alvarohqr/Sunny/ThousandSunny/CON_MSP430F5529.jpg

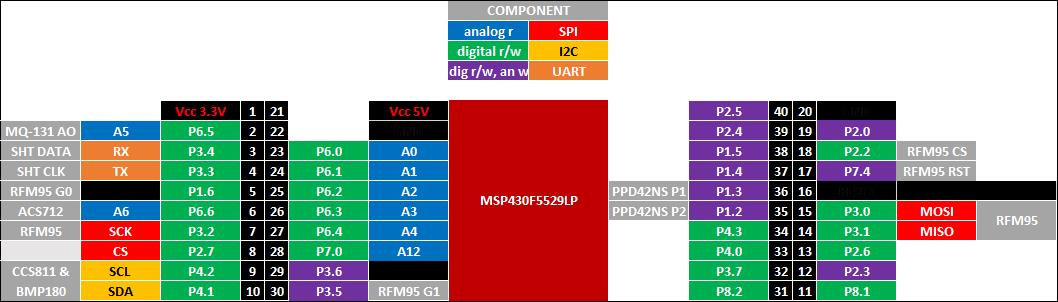
ThousandSunny/CON_MSP430F5529.jpg
