alvarohqr/Sunny/README.md

# A LoRaWAN Air Quality and Meteorological monitoring system based on a MSP430FR5529LP Texas Instruments launchpad.
