alvarohqr/Sunny/PCB/README.md

Thousand Sunny Printed Circuit Board Files.
Software: EaglePCB for designd and EasyEDA for costumization.

IMPORTANT NOTE: the Protection Circuit uses a IRF9Z34 transistor while the Power Saving Circuit a IRLZ44N.
