alvarohqr/Sunny/Energia Libraries/readme.md

Source files for each sensor and the LoRa transceiver.
