alvarohqr/Sunny/ThousandSunny/sensor_node.md

Sensor/End Node components summary:

|Component| Description|
| --- | --- |
|MSP430F5529|Low-power microcontroller.|
|SX1276| 868MHz - 915 MHz LoRa transceiver.|
|SHT10| Temperature & relative humidity sensor.|
|BMP180| Temperature, relative humidity,<br /> and pressure sensor.|
|CCS811| Carbon dioxide and Total Volatile<br /> Organic Compounds (TVOCs) sensor.|
|MQ-131| Ozone sensor.|
|PPD42NS|$PM_{2.5}$ & $PM_{10}$ sensor.|
|ACS712| Current sensor combined with a<br /> solar cell to measure sollar irradiation.|
