alvarohqr/Sunny/PCB/ThousandSunny.png

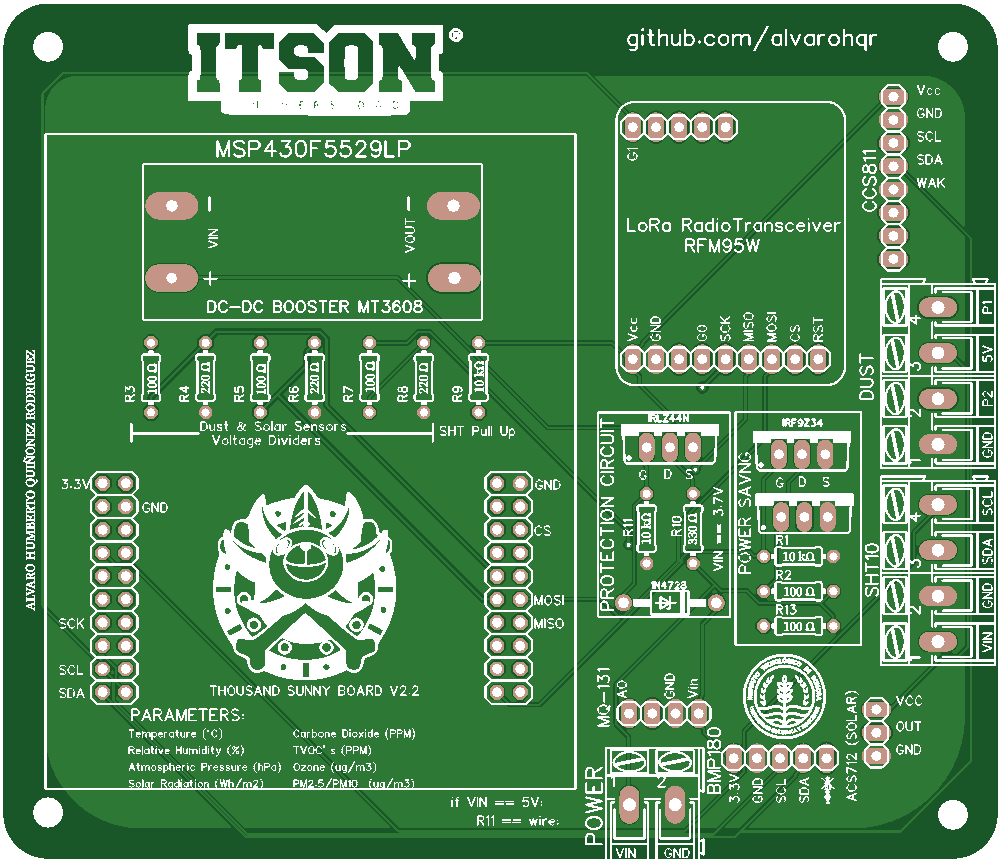
PCB/ThousandSunny.png
