alvarohqr/Sunny/PCB/ThousandSunny.pdf

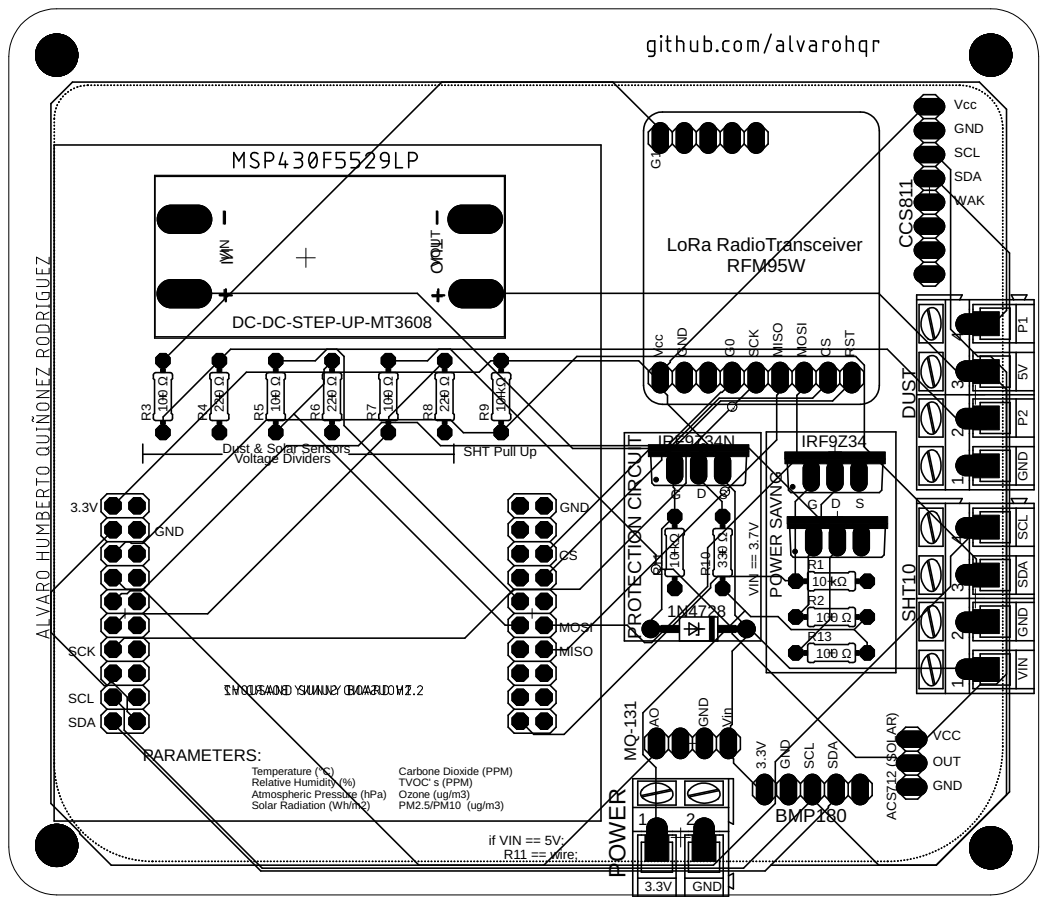
[picture p6: page 1]

GND SDA SCL P2 P1 GND

Vcc GND G0 SCK MISO MOSI CSRST
