alvarohqr/Sunny/(list of files, drawings)

Other design files:
Energia Libraries/Energia-MQ131/extras/MQ131_Arduino_Uno_circuit.fzz
