alvarohqr/Sunny/PCB/ThousandSunny.brd

## EAGLE design PCB/ThousandSunny.brd (2022-12-30)

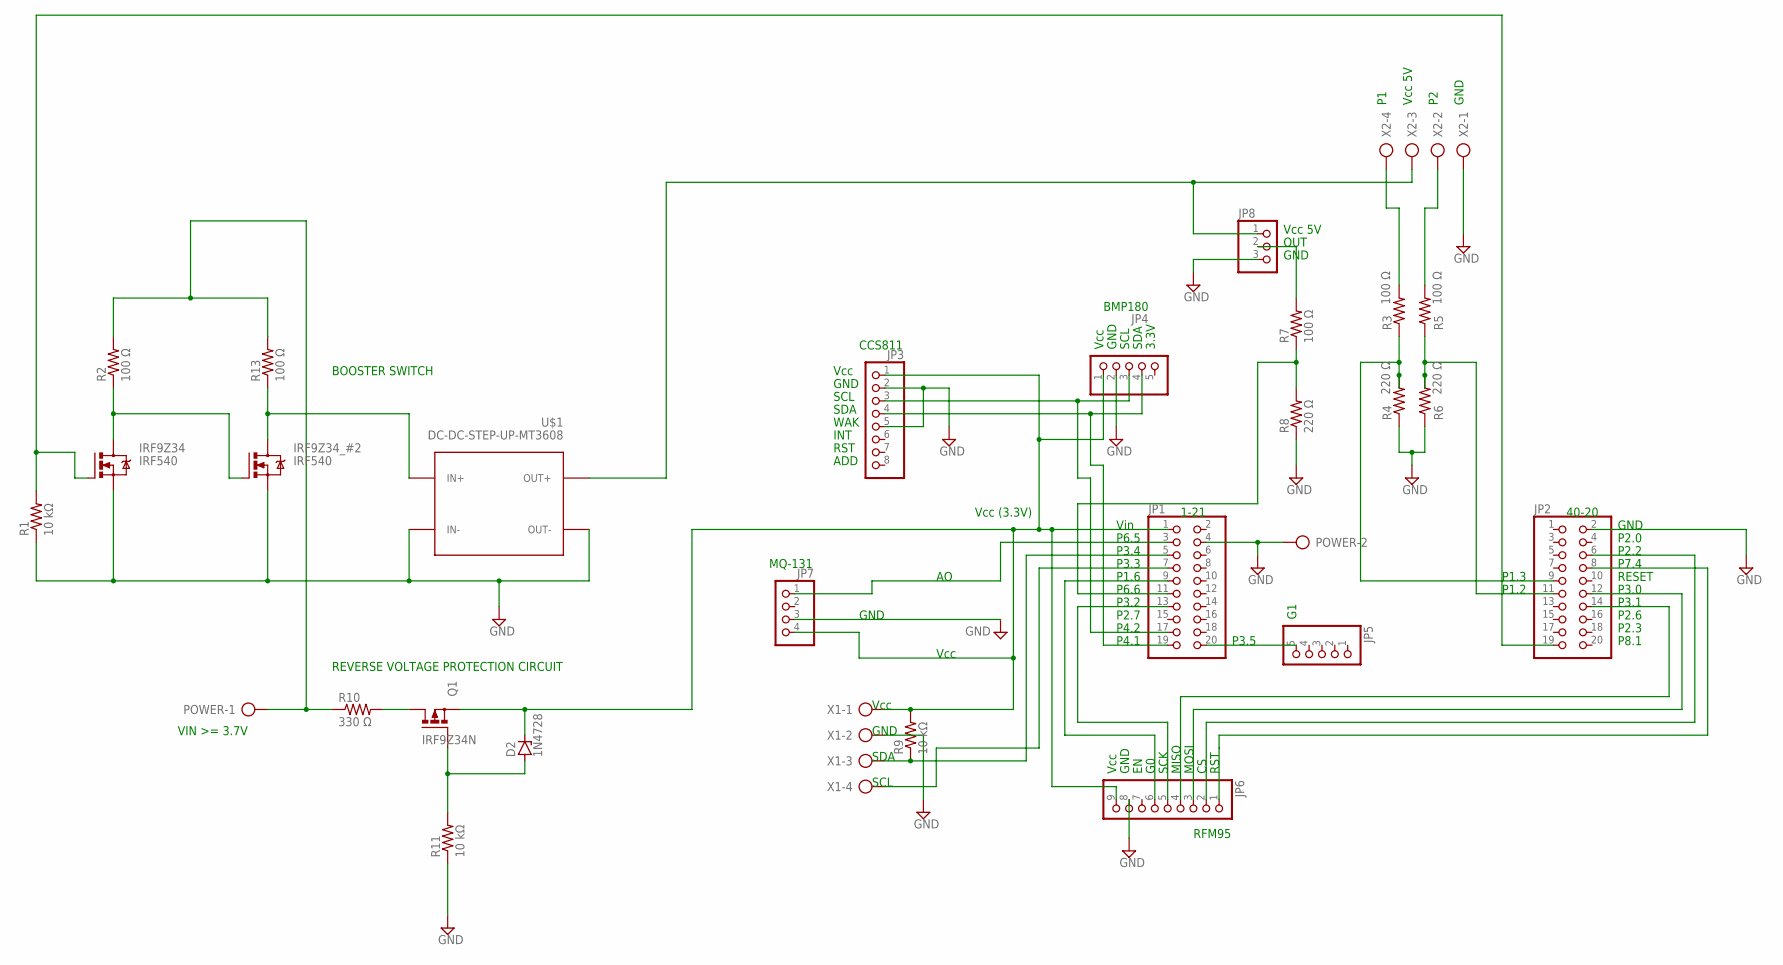
[picture p7: schematic ThousandSunny.sch]

Parts:
D2: 1N4728; DO41Z10
IRF9Z34, IRF9Z34_#2: IRF540; TO220BV
JP1, JP2: PINHD-2X10; 2X10
JP3: PINHD-1X8; 1X08
JP4, JP5: PINHD-1X5; 1X05
JP6: PINHD-1X9; 1X09
JP7: PINHD-1X4; 1X04
JP8: PINHD-1X3; 1X03
POWER: AK300/2
Q1: IRF9Z34N; TO220BV
R1, R9, R11: 10 kΩ; 0204/7
R2, R3, R5, R7, R13: 100 Ω; 0204/7
R4, R6, R8: 220 Ω; 0204/7
R10: 330 Ω; 0204/7
U$1: DC-DC-STEP-UP-MT3608
X1, X2: AK300/4

Connections:
ANODE: D2.A, Q1.G, R11.2
BATTERY: POWER.1, R2.2, R10.1, R13.2
D1->G2: IRF9Z34.D, IRF9Z34_#2.G, R2.1
D2->VIN: IRF9Z34_#2.D, R13.1, U$1.IN+
DRAIN_Q1: Q1.D, R10.2
DUST_P1: JP2.9, R3.1, R4.2
DUST_P2: JP2.11, R5.1, R6.2
G1: JP1.20, JP5.5
GND: IRF9Z34.S, IRF9Z34_#2.S, JP1.4, JP2.2, JP3.2, JP3.5, JP4.2, JP6.8, JP7.3, JP8.3, POWER.2, R1.1, R4.1, R6.1, R8.1, R11.1, U$1.IN-, U$1.OUT-, X1.2, X2.1
MISO: JP2.14, JP6.4
MOSI: JP2.12, JP6.3
O3: JP1.3, JP7.1
P8.2: IRF9Z34.G, JP2.19, R1.2
RAW_P1: R3.2, X2.4
RAW_P2: R5.2, X2.2
RAW_SOLAR: JP8.2, R7.2
RFM95W_CS: JP2.6, JP6.2
RFM95W_G0: JP1.9, JP6.6
RFM95_RST: JP2.8, JP6.1
SCK: JP1.13, JP6.5
SCL: JP1.17, JP3.3, JP4.3
SDA: JP1.19, JP3.4, JP4.4
SHT_CLOCK: JP1.7, X1.4
SHT_DATA: JP1.5, R9.1, X1.3
SOLAR: JP1.11, R7.1, R8.2
VIN->DUST: JP8.1, U$1.OUT+, X2.3
VZ->3.3V: D2.C, JP1.1, JP3.1, JP4.1, JP6.9, JP7.4, Q1.S, R9.2, X1.1

Notes on the sheet:
Vcc (3.3V)
Vcc
GND
SCK
MISO
MOSI
RST
Vin
P6.5
P3.4
P3.3
P1.6
P6.6
P3.2
P2.7
P4.2
P4.1
SCL
SDA
WAK
INT
ADD
P2.0
P7.4
RESET
P3.0
P3.1
P2.6
P2.3
P8.1
P2.2
P3.5
P1.3
P1.2
3.3V
Vcc 5V
1-21
40-20
CCS811
BMP180
RFM95
MQ-131
REVERSE VOLTAGE PROTECTION CIRCUIT
VIN >= 3.7V
BOOSTER SWITCH
OUT

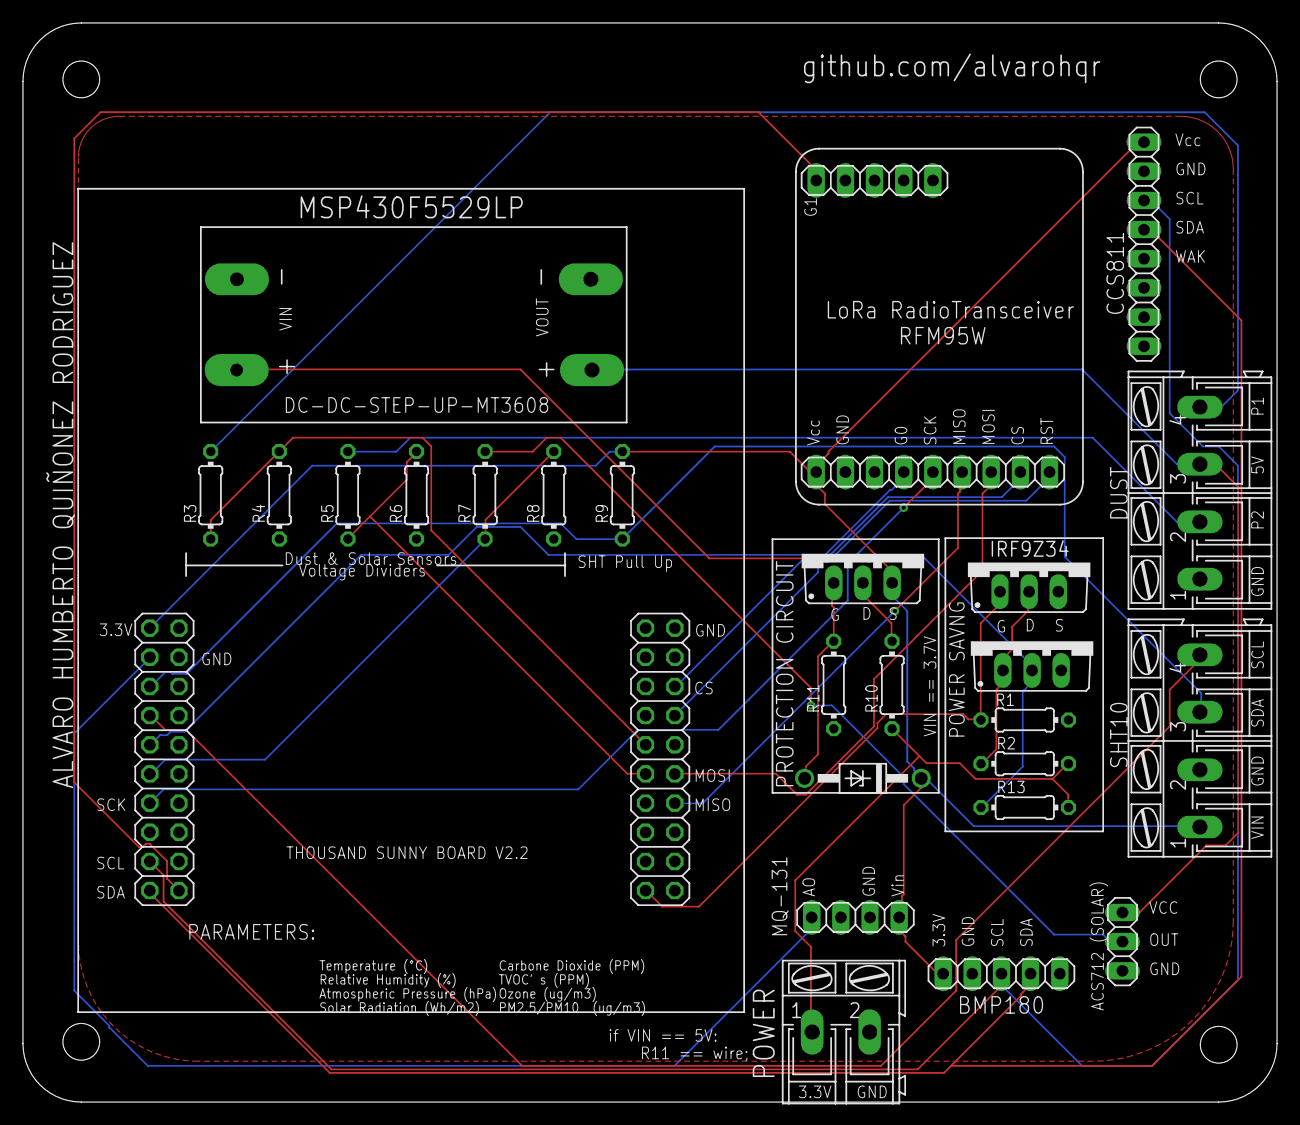
[picture p8: board ThousandSunny.brd from above]

Board: 2 copper layers, 109.2 x 94.0 mm, 28 parts (1 on the bottom side), 27 nets.
