alvarohqr/Sunny/ThousandSunny/Thousand_Sunny.ino

#include <lmic.h>
#include <hal/hal.h>
#include <SPI.h>
#include "TTN_RFM95W.h"

static uint8_t payload[16]; 
static osjob_t sendjob;

// Schedule TX every this many seconds 
// En este caso se define como cero y el parametro 
// para la transmisión se define por el tiempo en reposo.
const unsigned TX_INTERVAL = 0; 

// Pin mapping
const lmic_pinmap lmic_pins = {
  RFM95_CS,   //nss
  LMIC_UNUSED_PIN,    //rxtx
  RFM95_RST,  //rst
  {RFM95_DIO0, RFM95_DIO1, LMIC_UNUSED_PIN},  //{GPIO0, GPIO1, GPIO2}
};

typedef uint16_t u16_t;

//! Variables globales
float temp = 0, hum = 0, temp_i = 0, prsn = 0, con_ugm3 = 0, con2_ugm3 = 0;
u16_t temperature, humidity, pressure, ozone, PM2_5, PM10;
float O3_ppm = -1, O3_ug = -1, R0 = 0;
u16_t eCO2 = -1, TVOC = -1;

void onEvent (ev_t ev) {
  Serial.print(os_getTime());
  Serial.print(": ");
  switch (ev) {
    case EV_SCAN_TIMEOUT:
      Serial.println(F("EV_SCAN_TIMEOUT"));
      break;
    case EV_BEACON_FOUND:
      Serial.println(F("EV_BEACON_FOUND"));
      break;
    case EV_BEACON_MISSED:
      Serial.println(F("EV_BEACON_MISSED"));
      break;
    case EV_BEACON_TRACKED:
      Serial.println(F("EV_BEACON_TRACKED"));
      break;
    case EV_JOINING:
      Serial.println(F("EV_JOINING"));
      break;
    case EV_JOINED:
      Serial.println(F("EV_JOINED"));
      break;
    case EV_RFU1:
      Serial.println(F("EV_RFU1"));
      break;
    case EV_JOIN_FAILED:
      Serial.println(F("EV_JOIN_FAILED"));
      break;
    case EV_REJOIN_FAILED:
      Serial.println(F("EV_REJOIN_FAILED"));
      break;
    case EV_TXCOMPLETE:
      Serial.println(F("EV_TXCOMPLETE (includes waiting for RX windows)"));
      if (LMIC.txrxFlags & TXRX_ACK)
        Serial.println(F("Received ack"));
      if (LMIC.dataLen) {
        Serial.println(F("Received "));
        Serial.println(LMIC.dataLen);
        Serial.println(F(" bytes of payload"));
      }
      // Schedule next transmission
      os_setTimedCallback(&sendjob, os_getTime() + sec2osticks(TX_INTERVAL), do_send);
      sleep(60000);	//! Transmite al menos cada 10 minutos.
      break;
    case EV_LOST_TSYNC:
      Serial.println(F("EV_LOST_TSYNC"));
      break;
    case EV_RESET:
      Serial.println(F("EV_RESET"));
      break;
    case EV_RXCOMPLETE:
      // data received in ping slot
      Serial.println(F("EV_RXCOMPLETE"));
      break;
    case EV_LINK_DEAD:
      Serial.println(F("EV_LINK_DEAD"));
      break;
    case EV_LINK_ALIVE:
      Serial.println(F("EV_LINK_ALIVE"));
      break;
    default:
      Serial.println(F("Unknown event"));
      break;
  }
}

void do_send(osjob_t* j) {
  // Check if there is not a current TX/RX job running
  if (LMIC.opmode & OP_TXRXPEND) {
    Serial.println(F("OP_TXRXPEND, not sending"));
  } else {
    //! Lectura de datos
    read_ppd42ns();
    read_sht();
    read_ccs811();
    read_bmp();
    read_o3();
    
    
    temperature = (u16_t)(temp * 100); // Type casting float a uint16_t
    humidity = (u16_t)(hum * 100);
    pressure = (u16_t)(prsn);
    ozone = (u16_t)(O3_ug * 100);
    PM2_5 = (u16_t)(con_ugm3 *100);
    PM10  = (u16_t)(con2_ugm3 *100);
    
    //! Enpaquetado de datos
    payload[0]  = highByte(temperature); payload[1] = lowByte(temperature);
    payload[2]  = highByte(humidity); payload[3] = lowByte(humidity);
    payload[4]  = highByte(eCO2); payload[5] = lowByte(eCO2);
    payload[6]  = highByte(TVOC); payload[7] = lowByte(TVOC);
    payload[8]  = highByte(pressure); payload[9] = lowByte(pressure);
    payload[10] = highByte(ozone); payload[11] = lowByte(ozone);
    payload[12] = highByte(PM2_5); payload[13] = lowByte(PM2_5);
    payload[14] = highByte(PM10); payload[15] = lowByte(PM10);
    
    // Prepare upstream data transmission at the next possible time.
    LMIC_setTxData2(1, payload, sizeof(payload), 0);
    Serial.println(F("Packet queued"));
  }
  // Next TX is scheduled after TX_COMPLETE event.
}

void setup() {
  Serial.begin(115200);
  Serial.println(F("Starting"));
  setup_ppd42ns();
  init_gpio();
  setup_ccs811();
  delay(1000); //! El sensor CCS811 necesita 1 segundo para estabilizarse.
  setup_bmp();
  setup_o3();
  
  
  // LMIC init
  os_init();
  // Reset the MAC state. Session and pending data transfers will be discarded.
  LMIC_reset();

  // Set static session parameters. Instead of dynamically establishing a session
  // by joining the network, precomputed session parameters are be provided.
#ifdef PROGMEM
  // On AVR, these values are stored in flash and only copied to RAM
  // once. Copy them to a temporary buffer here, LMIC_setSession will
  // copy them into a buffer of its own again.
  uint8_t appskey[sizeof(APPSKEY)];
  uint8_t nwkskey[sizeof(NWKSKEY)];
  memcpy_P(appskey, APPSKEY, sizeof(APPSKEY));
  memcpy_P(nwkskey, NWKSKEY, sizeof(NWKSKEY));
  LMIC_setSession (0x1, DEVADDR, nwkskey, appskey);
#else
  // If not running an AVR with PROGMEM, just use the arrays directly
  LMIC_setSession (0x1, DEVADDR, NWKSKEY, APPSKEY);
#endif

#if defined(CFG_eu868)
  // Set up the channels used by the Things Network, which corresponds
  // to the defaults of most gateways. Without this, only three base
  // channels from the LoRaWAN specification are used, which certainly
  // works, so it is good for debugging, but can overload those
  // frequencies, so be sure to configure the full frequency range of
  // your network here (unless your network autoconfigures them).
  // Setting up channels should happen after LMIC_setSession, as that
  // configures the minimal channel set.
  // NA-US channels 0-71 are configured automatically
  LMIC_setupChannel(0, 868100000, DR_RANGE_MAP(DR_SF12, DR_SF7),  BAND_CENTI);      // g-band
  LMIC_setupChannel(1, 868300000, DR_RANGE_MAP(DR_SF12, DR_SF7B), BAND_CENTI);      // g-band
  LMIC_setupChannel(2, 868500000, DR_RANGE_MAP(DR_SF12, DR_SF7),  BAND_CENTI);      // g-band
  LMIC_setupChannel(3, 867100000, DR_RANGE_MAP(DR_SF12, DR_SF7),  BAND_CENTI);      // g-band
  LMIC_setupChannel(4, 867300000, DR_RANGE_MAP(DR_SF12, DR_SF7),  BAND_CENTI);      // g-band
  LMIC_setupChannel(5, 867500000, DR_RANGE_MAP(DR_SF12, DR_SF7),  BAND_CENTI);      // g-band
  LMIC_setupChannel(6, 867700000, DR_RANGE_MAP(DR_SF12, DR_SF7),  BAND_CENTI);      // g-band
  LMIC_setupChannel(7, 867900000, DR_RANGE_MAP(DR_SF12, DR_SF7),  BAND_CENTI);      // g-band
  LMIC_setupChannel(8, 868800000, DR_RANGE_MAP(DR_FSK,  DR_FSK),  BAND_MILLI);      // g2-band
  // TTN defines an additional channel at 869.525Mhz using SF9 for class B
  // devices' ping slots. LMIC does not have an easy way to define set this
  // frequency and support for class B is spotty and untested, so this
  // frequency is not configured here.
#elif defined(CFG_us915)
  // NA-US channels 0-71 are configured automatically
  // but only one group of 8 should (a subband) should be active
  // TTN recommends the second sub band, 1 in a zero based count.
  // https://github.com/TheThingsNetwork/gateway-conf/blob/master/US-global_conf.json
  LMIC_selectSubBand(1);
#endif

  // Disable link check validation
  LMIC_setLinkCheckMode(0);

  // TTN uses SF9 for its RX2 window.
  LMIC.dn2Dr = DR_SF9;

  // Set data rate and transmit power for uplink (note: txpow seems to be ignored by the library)
  LMIC_setDrTxpow(DR_SF7, 14);

  // Start job
  do_send(&sendjob);
}

void loop() {
  os_runloop_once();
}

void init_gpio() {
  //UCSCTL4 = SELA_1;
  P1OUT = 0x00; P2OUT = 0x00; P3OUT = 0x00; P4OUT = 0x00; P5OUT = 0x00; //P6OUT = 0x00;
  //PJOUT = 0x00;
  P1DIR = 0xFF; P2DIR = 0xFF; P3DIR = 0xFF; P4DIR = 0xFF; P5DIR = 0xFF; //P6DIR = 0xFF;
  //PJDIR = 0xFF;
}
