alvarohqr/Sunny/(commit log)

2022-10-05 Pin Map
2022-10-05 Sensor node components summary
2022-10-05 Sensor node summary
2022-10-05 Interact Adafruit devices
2022-10-05 Components Source Files
    [MQ131_Arduino_Uno_circuit.fzz, Sensitivity_curves.xlsx]
2022-10-05 Sensor Node
2022-10-09 Board logo
2022-10-09 Gerber files
2022-10-09 PCB files
2022-10-18 Power Consumption Data
    [BMP Comp..xlsx, BMP_EnergyTrace_2022_08_02_211659.csv, BMP_NOPT.csv, BMP_OPT.xlsx, EnergyTrace_2022_05_05_171423.csv, EnergyTrace_2022_05_05_171423.xlsx, LoRa.xlsx, MQ131_EnergyTrace_2022_05_06_183339.csv]
2022-12-30 Board Bill of Materials
    [ThousandSunny.brd, ThousandSunny.sch]
2022-12-30 Update BOM.txt
    Board Bill of Materials
2022-12-30 Print Files
2022-12-30 ThousandSunny PCB
